joebritt/usb2cmi/README.md

# usb2cmi
USB Keyboard &amp; Mouse interface for the Fairlight CMI

More info can be found here:

https://docs.google.com/document/d/1SBbrsyc7bVfPzIFhJmcOLwGjMr6u-KO0Lp5tNpQLhYE/edit?usp=sharing
