joebritt/usb2cmi/USB2CMI_2018/usb2cmi_s3.pdf

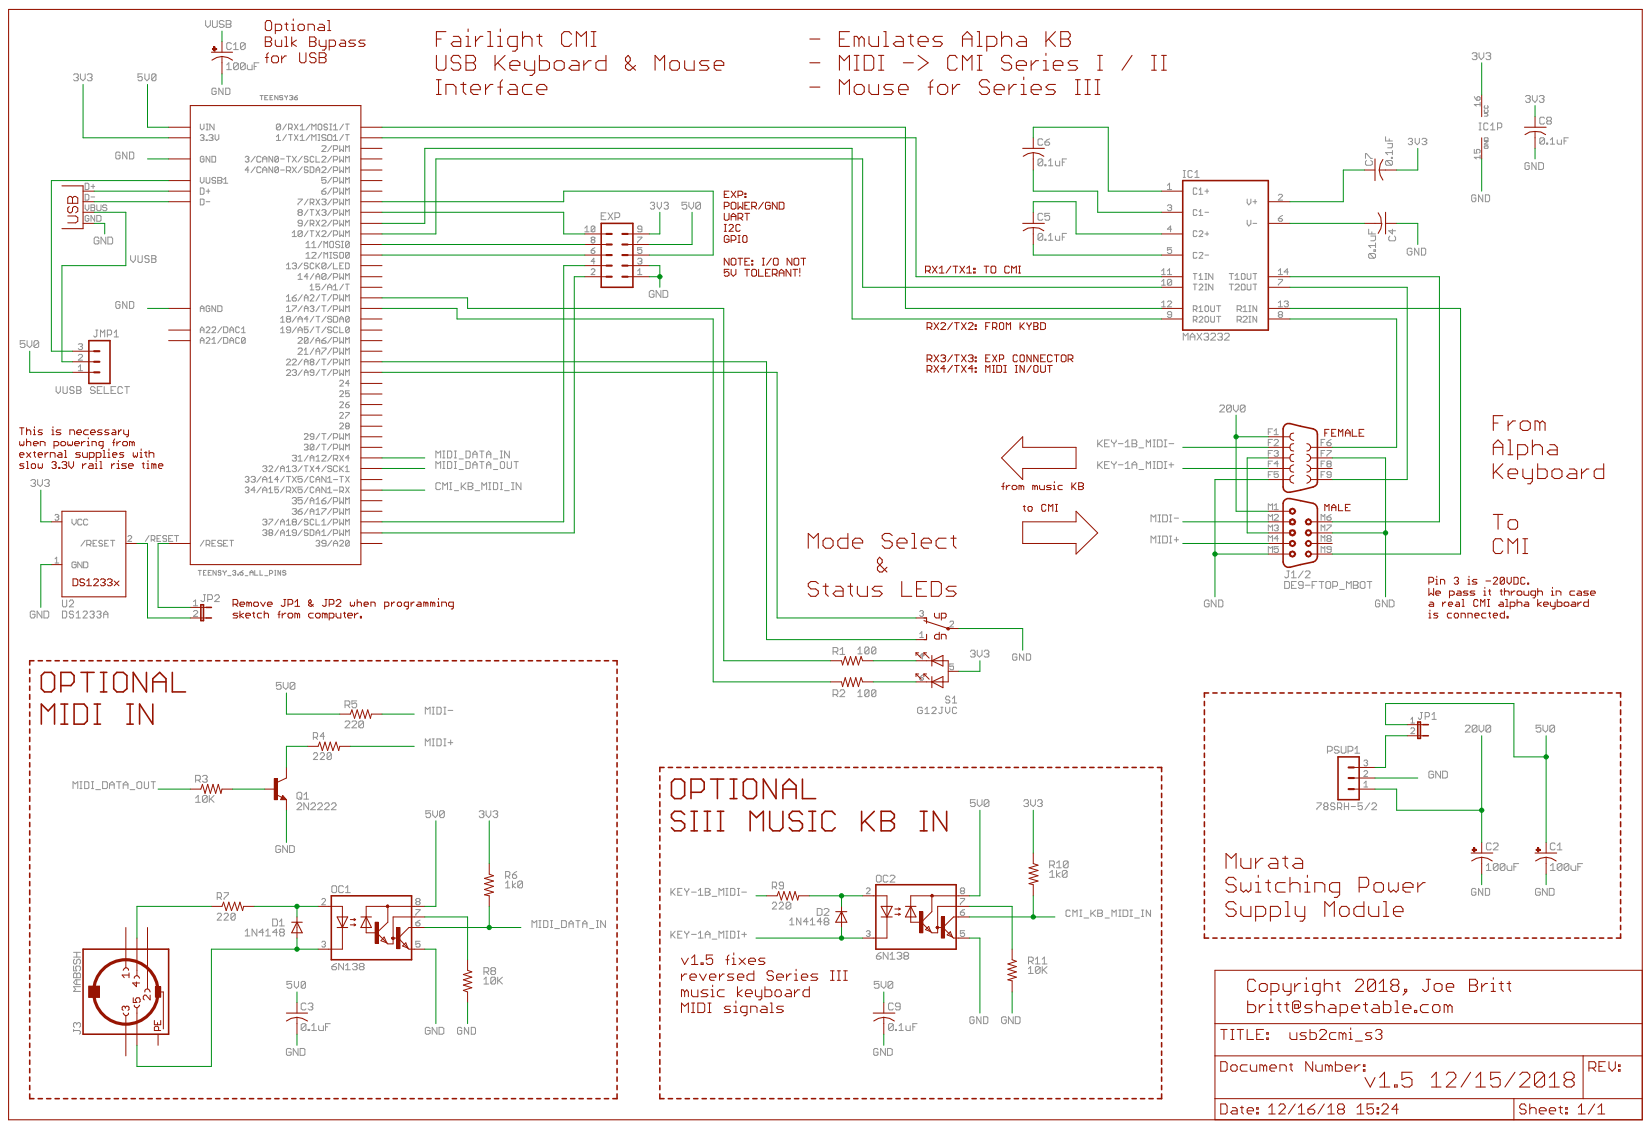
[picture p1: page 1]
