joebritt/usb2cmi/USB2CMI_2018/usb2cmi_s3_disp_sch.pdf

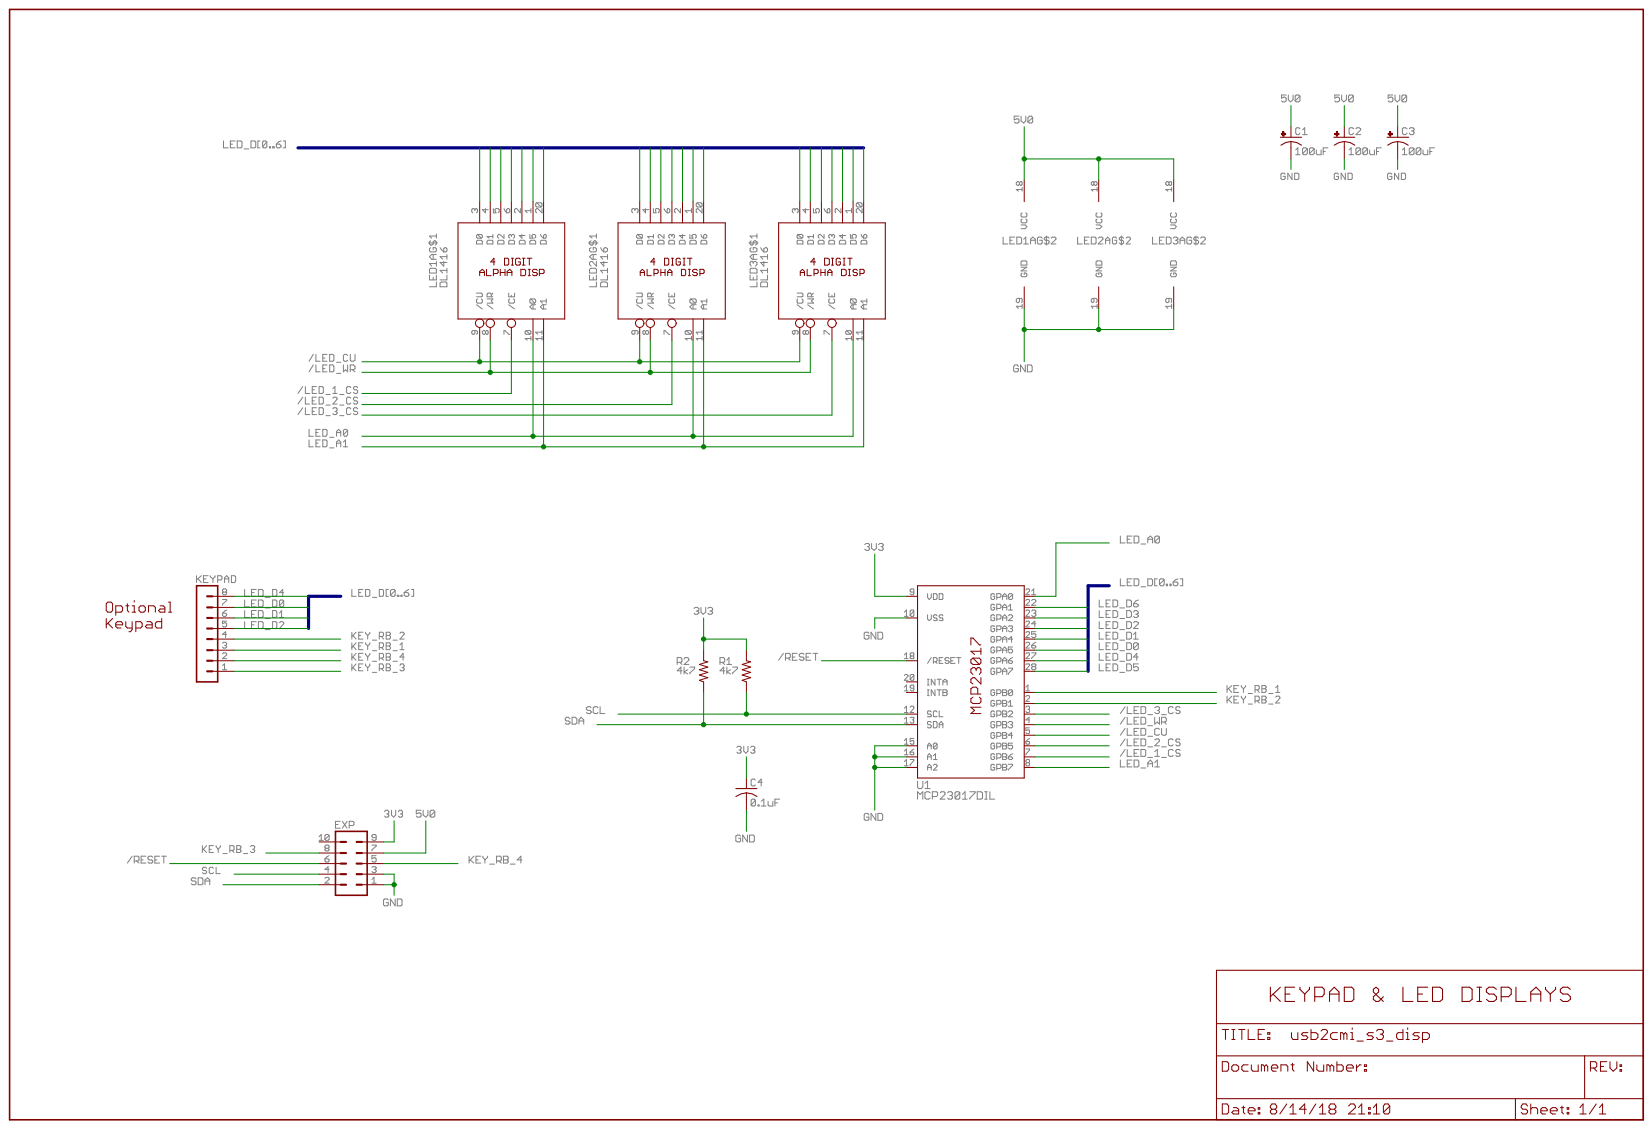
[picture p2: page 1]
