joebritt/usb2cmi/USB2CMI_2018/usb2cmi_s3_sch.pdf

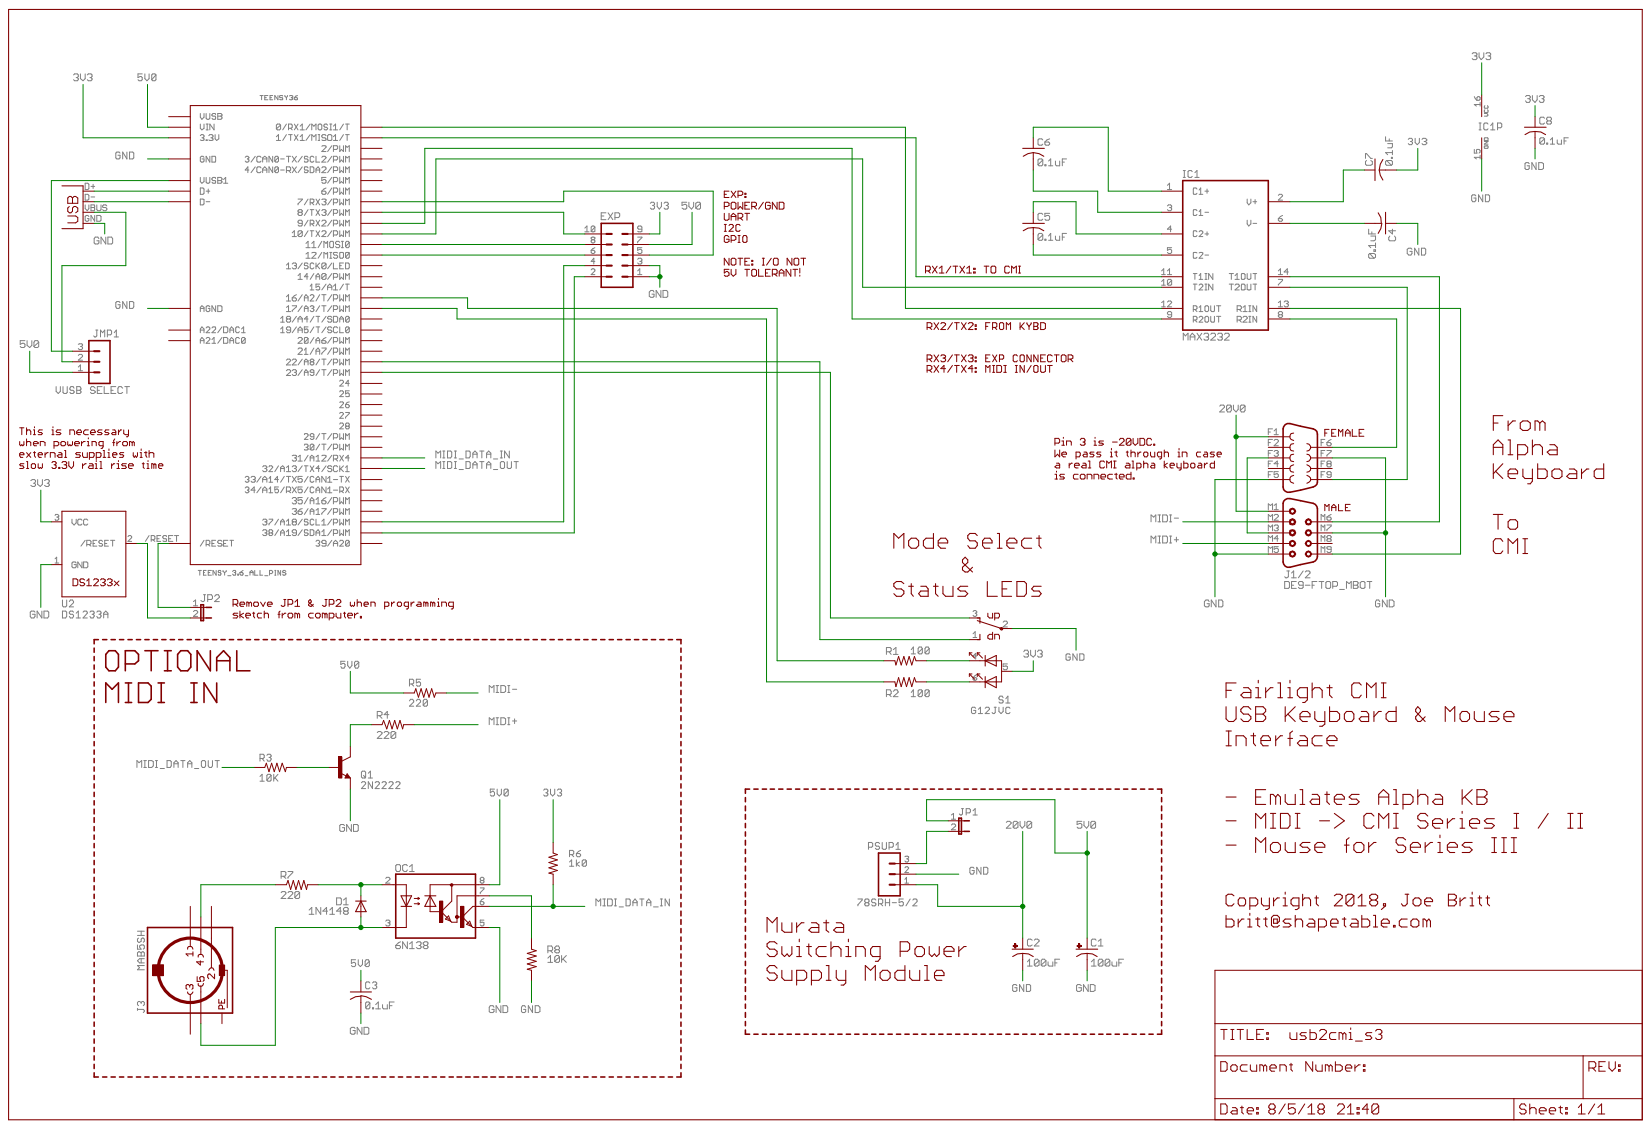
[picture p3: page 1]
