joebritt/usb2cmi/USB2CMI_2018/usb2cmi_mini_disp.brd

## EAGLE design USB2CMI_2018/usb2cmi_mini_disp.brd (2019-04-12)

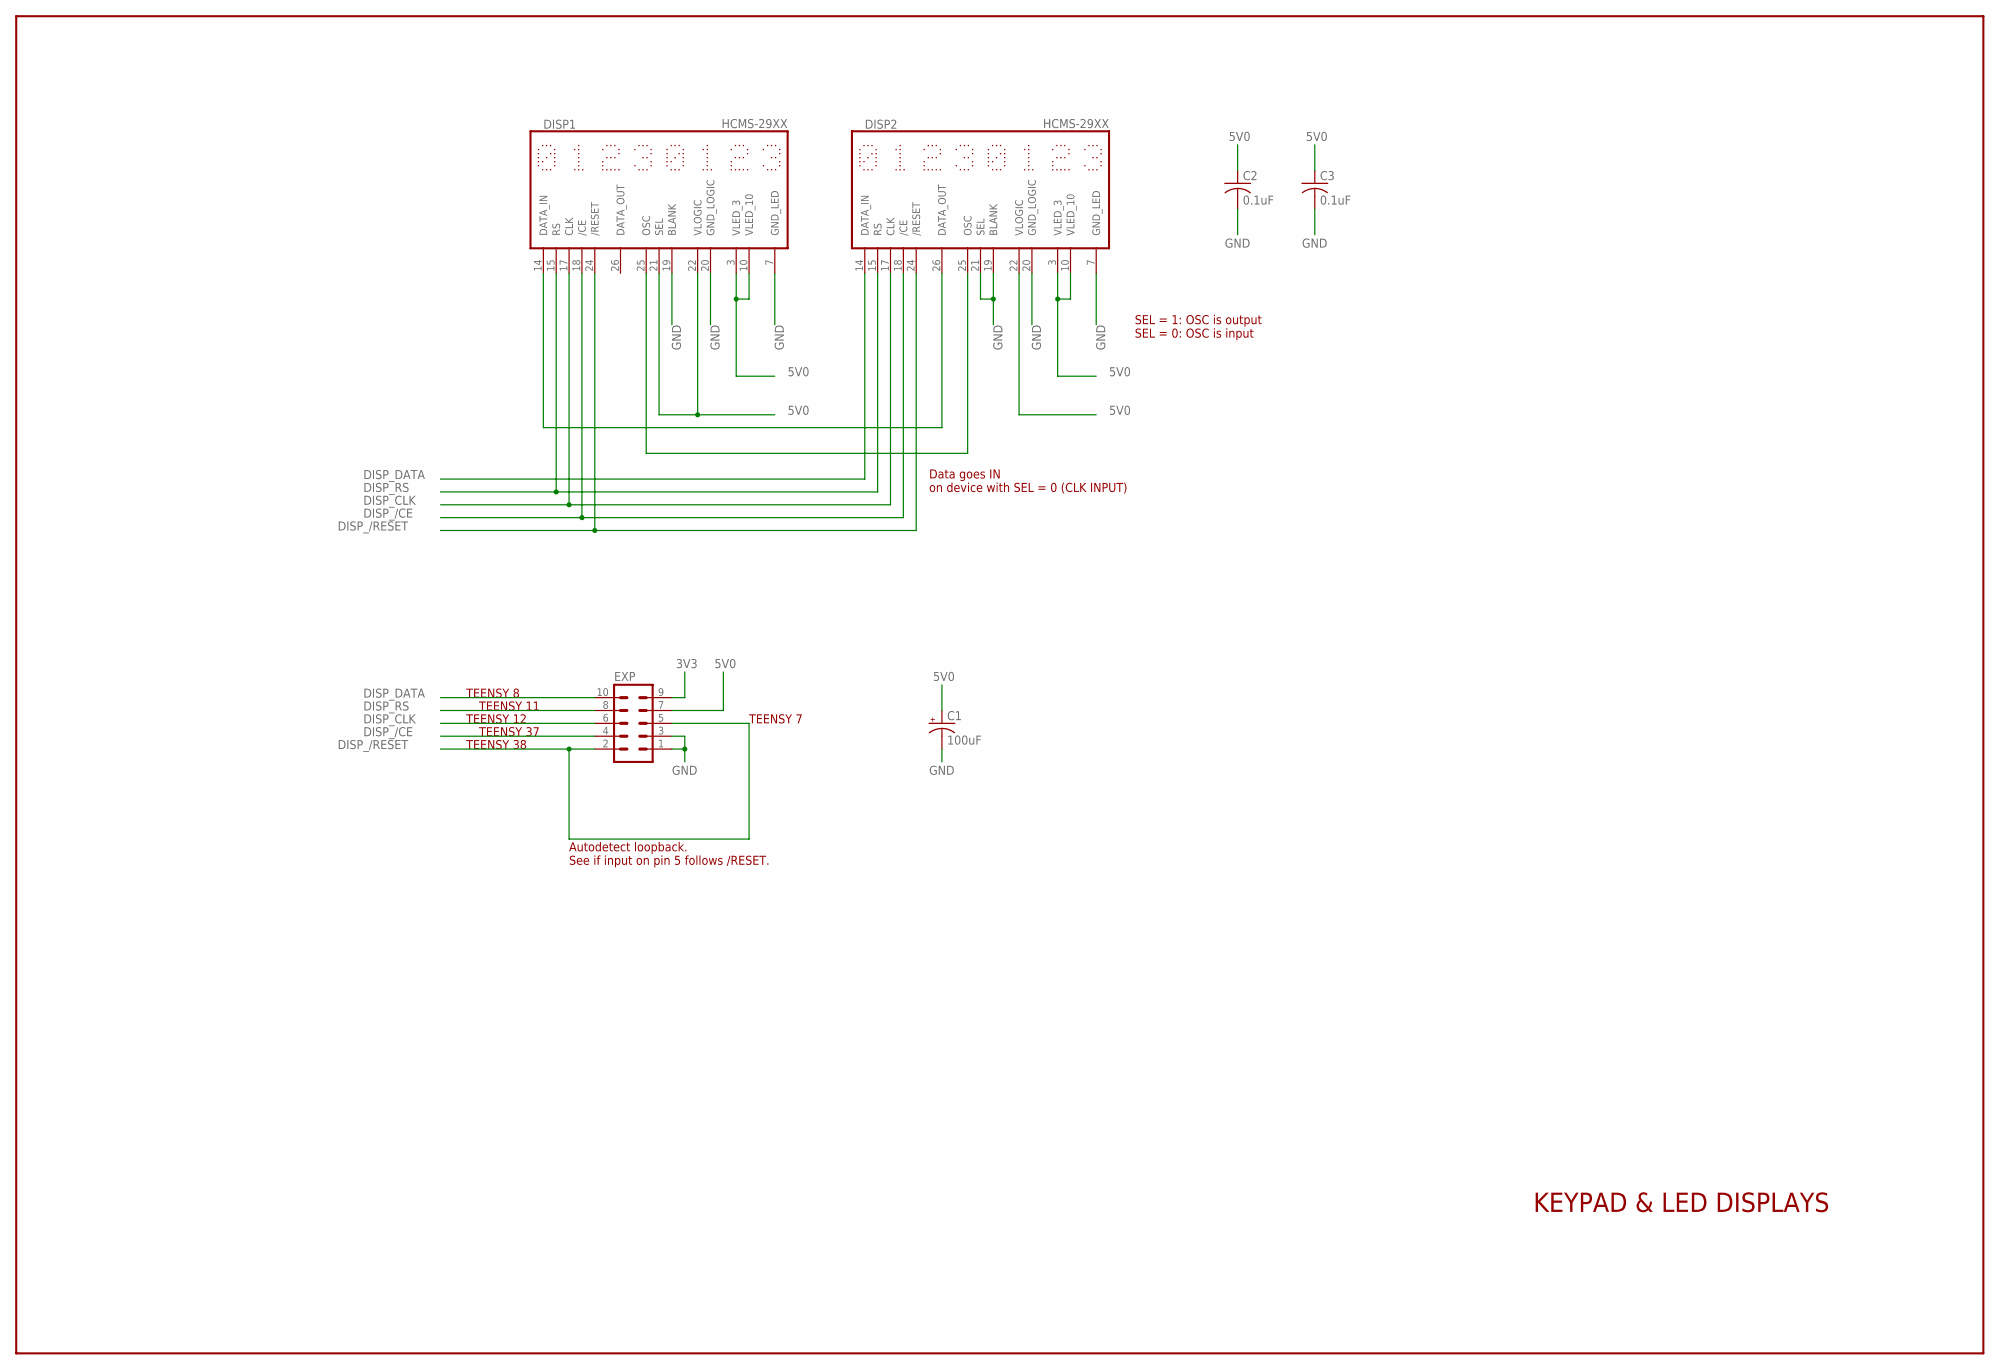
[picture p4: schematic usb2cmi_mini_disp.sch]

Parts:
C1: 100uF; E2,5-7
C2, C3: 0.1uF; C050-025X075
DISP1, DISP2: HCMS-29XX
EXP: MA05-2

Connections:
3V3: EXP.9
5V0: C1.+, C2.1, C3.1, DISP1.3 (VLED_3), DISP1.10 (VLED_10), DISP1.21 (SEL), DISP1.22 (VLOGIC), DISP2.3 (VLED_3), DISP2.10 (VLED_10), DISP2.22 (VLOGIC), EXP.7
DISP_/CE: DISP1.18 (/CE), DISP2.18 (/CE), EXP.4
DISP_/RESET: DISP1.24 (/RESET), DISP2.24 (/RESET), EXP.2, EXP.5
DISP_CLK: DISP1.17 (CLK), DISP2.17 (CLK), EXP.6
DISP_DATA: DISP2.14 (DATA_IN), EXP.10
DISP_RS: DISP1.15 (RS), DISP2.15 (RS), EXP.8
GND: C1.-, C2.2, C3.2, DISP1.7 (GND_LED), DISP1.19 (BLANK), DISP1.20 (GND_LOGIC), DISP2.7 (GND_LED), DISP2.19 (BLANK), DISP2.20 (GND_LOGIC), DISP2.21 (SEL), EXP.1, EXP.3
unnamed: DISP1.14 (DATA_IN), DISP2.26 (DATA_OUT)
unnamed: DISP1.25 (OSC), DISP2.25 (OSC)

Notes on the sheet:
KEYPAD & LED DISPLAYS
SEL = 1: OSC is output SEL = 0: OSC is input
Autodetect loopback. See if input on pin 5 follows /RESET.
Data goes IN on device with SEL = 0 (CLK INPUT)
TEENSY 7
TEENSY 38
TEENSY 37
TEENSY 12
TEENSY 11
TEENSY 8

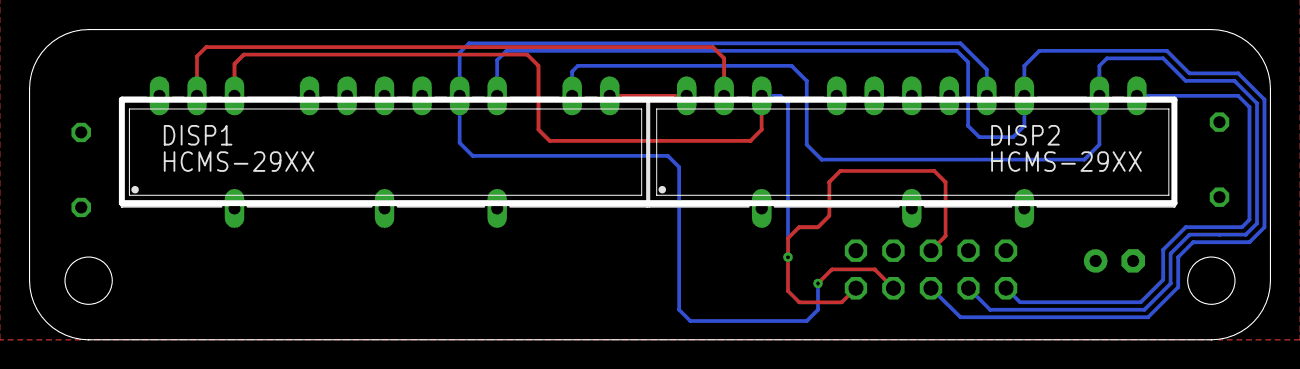
[picture p5: board usb2cmi_mini_disp.brd from above]

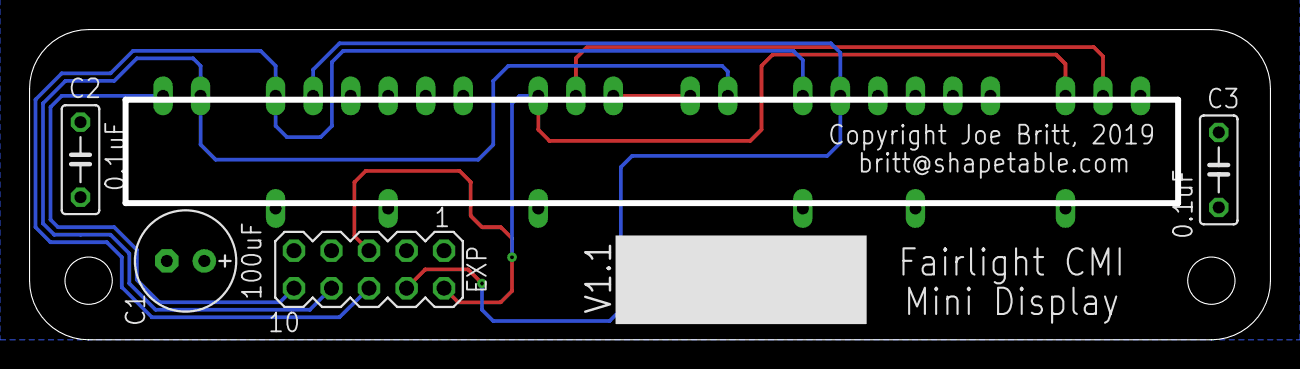
[picture p6: board usb2cmi_mini_disp.brd from below]

Board: 2 copper layers, 84.0 x 21.0 mm, 6 parts (4 on the bottom side), 9 nets.
