joebritt/usb2cmi/USB2CMI_2018/usb2cmi_s3.brd

## EAGLE design USB2CMI_2018/usb2cmi_s3.brd (2018-12-16)

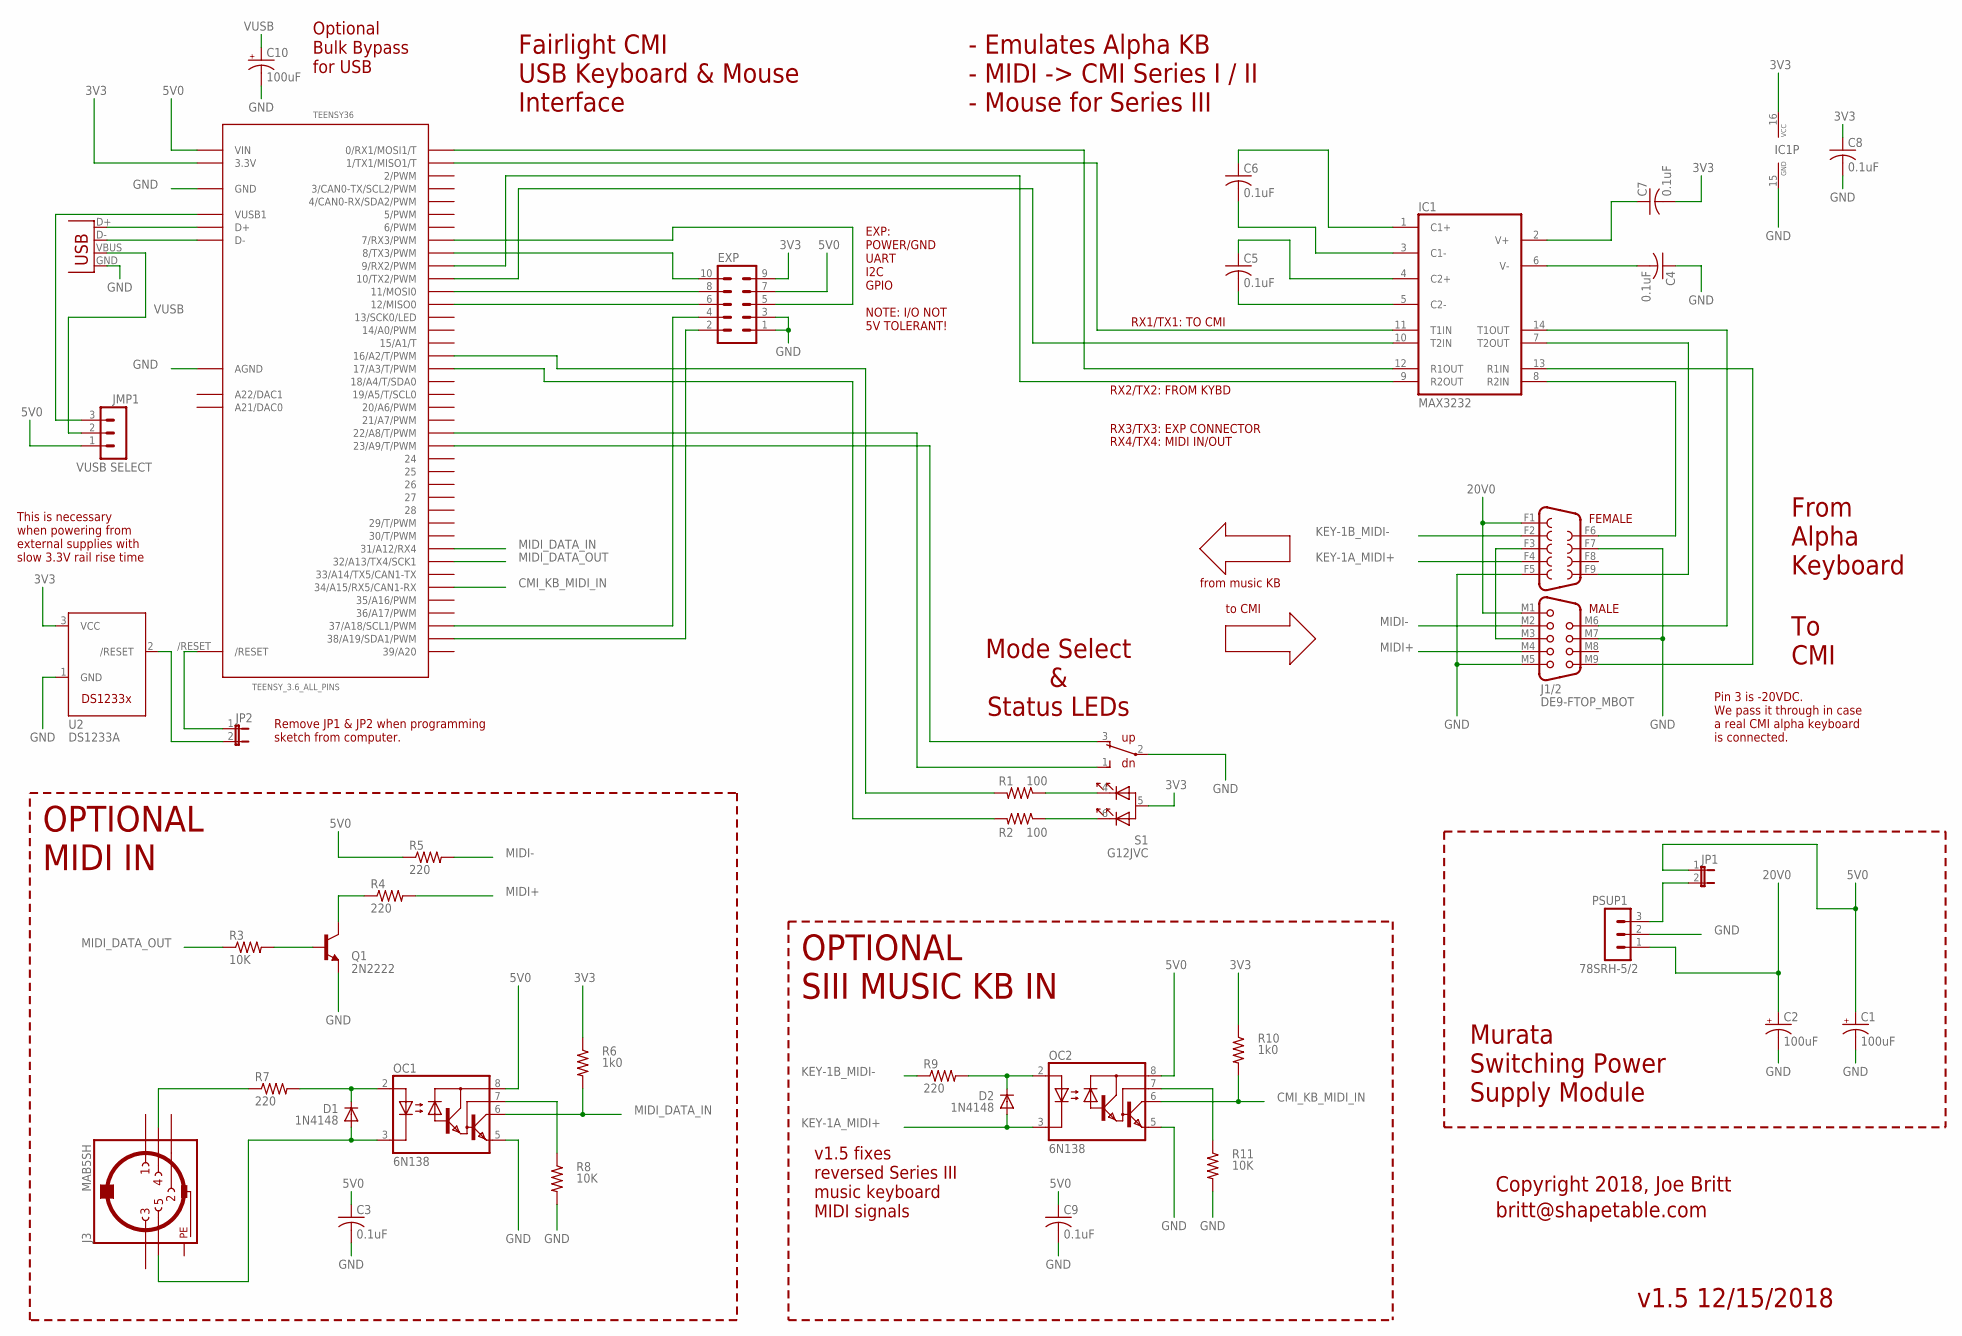
[picture p7: schematic usb2cmi_s3.sch]

Parts:
C1, C10: 100uF; E2,5-7
C2: 100uF; E3,5-10
C3, C4, C5, C6, C7, C8, C9: 0.1uF; C050-025X075
D1, D2: 1N4148; DO35-7
EXP: MA05-2
IC1: MAX3232; DIL16
J1/2: DE9-FTOP_MBOT; DE9_FTOP_MBOT
J3: MAB5SH
J4: USB-A-H
JMP1: VUSB SELECT; MA03-1
JP1, JP2: JP1E; JP1
OC1, OC2: 6N138; DIL08-NARROW
PSUP1: 78SRH-5/2; MA03-1
Q1: 2N2222; TO92-EBC-OVAL
R1, R2: 100; 0207/10
R3, R8, R11: 10K; 0207/10
R4, R5, R7, R9: 220; 0207/10
R6, R10: 1k0; 0207/10
S1: G12JVC
TEENSY36: TEENSY_3.6_ALL_PINS
U2: DS1233A; TO-92-

Connections:
3V3: C7.2, C8.1, EXP.9, IC1.16 (VCC), R6.1, R10.1, S1.5 (A), TEENSY36.3.3V, TEENSY36.3.3V3 (3.3V), U2.3 (VCC)
5V0: C1.+, C3.1, C9.1, EXP.7, JMP1.1, JP1.1, OC1.8 (VCC), OC2.8 (VCC), R5.1, TEENSY36.VIN
20V0: C2.+, J1/2.F1, J1/2.M1, PSUP1.1
CMI_KB_MIDI_IN: OC2.6 (VO), R10.2, TEENSY36.34/A15 (34/A15/RX5/CAN1-RX)
GND: C1.-, C2.-, C3.2, C4.1, C8.2, C9.2, C10.-, EXP.1, EXP.3, IC1.15 (GND), J1/2.F5, J1/2.F7, J1/2.M5, J1/2.M7, J4.GND, OC1.5 (GND), OC2.5 (GND), PSUP1.2, Q1.E, R8.2, R11.2, S1.2 (COM), TEENSY36.AGND, TEENSY36.GND, TEENSY36.GND1 (GND), TEENSY36.GND3 (GND), TEENSY36.GND4 (GND), U2.1 (GND)
KEY-1A_MIDI+: D2.A, J1/2.F4, OC2.3 (C)
KEY-1B_MIDI-: J1/2.F2, R9.1
MIDI+: J1/2.M4, R4.2
MIDI-: J1/2.M2, R5.2
MIDI_DATA_IN: OC1.6 (VO), R6.2, TEENSY36.31/A12 (31/A12/RX4)
MIDI_DATA_OUT: R3.1, TEENSY36.32/A13 (32/A13/TX4/SCK1)
unnamed: JP2.1, TEENSY36./RESET
unnamed: JP2.2, U2.2 (/RESET)
unnamed: EXP.5, TEENSY36.7 (7/RX3/PWM)
unnamed: EXP.10, TEENSY36.8 (8/TX3/PWM)
unnamed: EXP.8, TEENSY36.11 (11/MOSI0)
unnamed: EXP.6, TEENSY36.12 (12/MISO0)
unnamed: IC1.9 (R2OUT), TEENSY36.9 (9/RX2/PWM)
unnamed: R1.1, S1.4 (K_RED)
unnamed: R2.1, S1.6 (K_GRN)
unnamed: R2.2, TEENSY36.17/A3 (17/A3/T/PWM)
unnamed: R1.2, TEENSY36.16/A2 (16/A2/T/PWM)
unnamed: S1.1 (DOWN), TEENSY36.22/A8 (22/A8/T/PWM)
unnamed: S1.3 (UP), TEENSY36.23/A9 (23/A9/T/PWM)
unnamed: J4.D+, TEENSY36.D+
unnamed: J4.D-, TEENSY36.D-
unnamed: JMP1.3, TEENSY36.VUSB1
unnamed: C5.2, IC1.5 (C2-)
unnamed: C5.1, IC1.4 (C2+)
unnamed: C6.2, IC1.3 (C1-)
unnamed: C6.1, IC1.1 (C1+)
unnamed: C4.2, IC1.6 (V-)
unnamed: IC1.11 (T1IN), TEENSY36.1 (1/TX1/MISO1/T)
unnamed: Q1.B, R3.2
unnamed: IC1.14 (T1OUT), J1/2.M6
unnamed: C7.1, IC1.2 (V+)
unnamed: D1.C, OC1.2 (A), R7.2
unnamed: D1.A, J3.5, OC1.3 (C)
unnamed: Q1.C, R4.1
unnamed: J3.4, R7.1
unnamed: IC1.13 (R1IN), J1/2.M9
unnamed: IC1.12 (R1OUT), TEENSY36.0 (0/RX1/MOSI1/T)
unnamed: IC1.10 (T2IN), TEENSY36.10 (10/TX2/PWM)
unnamed: IC1.8 (R2IN), J1/2.F6
unnamed: IC1.7 (T2OUT), J1/2.F9
unnamed: J1/2.F3, J1/2.M3
unnamed: OC1.7 (VB), R8.1
unnamed: JP1.2, PSUP1.3
unnamed: D2.C, OC2.2 (A), R9.2
unnamed: OC2.7 (VB), R11.1
PE: J3.PE, J3.PE@ (PE)
SCL1: EXP.4, TEENSY36.37/A18 (37/A18/SCL1/PWM)
SDA1: EXP.2, TEENSY36.38/A19 (38/A19/SDA1/PWM)
VUSB: C10.+, J4.VBUS, JMP1.2

Notes on the sheet:
OPTIONAL MIDI IN
Murata Switching Power Supply Module
From Alpha Keyboard
To CMI
RX1/TX1: TO CMI
RX2/TX2: FROM KYBD
RX3/TX3: EXP CONNECTOR
RX4/TX4: MIDI IN/OUT
EXP: POWER/GND UART I2C GPIO NOTE: I/O NOT 5V TOLERANT!
Mode Select & Status LEDs
Pin 3 is -20VDC. We pass it through in case a real CMI alpha keyboard is connected.
Copyright 2018, Joe Britt
britt@shapetable.com
Fairlight CMI USB Keyboard & Mouse Interface
- Emulates Alpha KB - MIDI -> CMI Series I / II - Mouse for Series III
This is necessary when powering from external supplies with slow 3.3V rail rise time
Remove JP1 & JP2 when programming sketch from computer.
from music KB
to CMI
OPTIONAL SIII MUSIC KB IN
Optional Bulk Bypass for USB
v1.5 fixes reversed Series III music keyboard MIDI signals
v1.5 12/15/2018

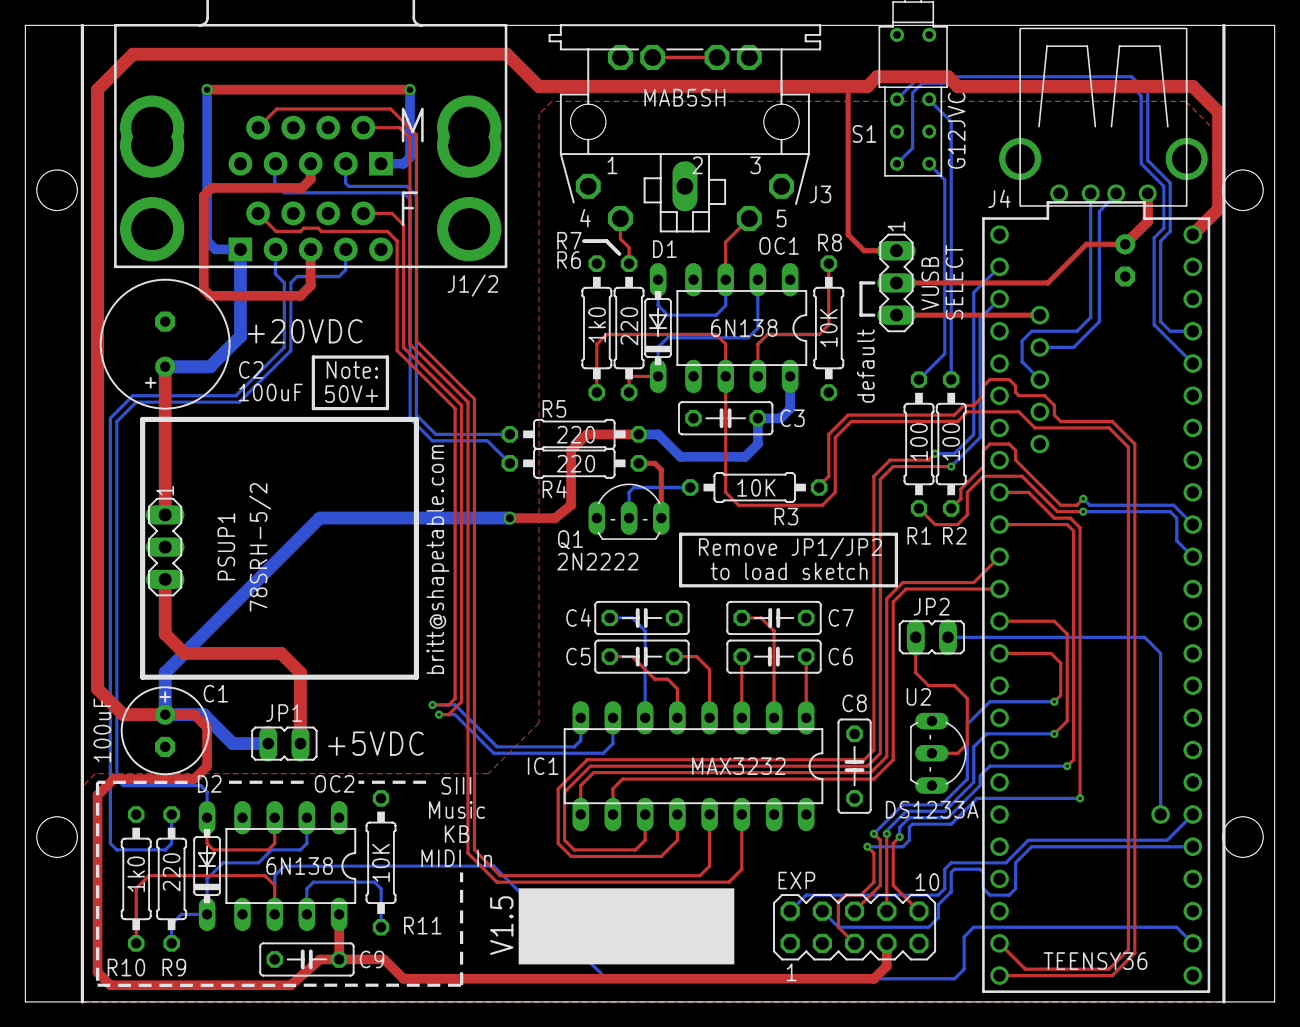
[picture p8: board usb2cmi_s3.brd from above]

Board: 2 copper layers, 98.5 x 77.0 mm, 38 parts (1 on the bottom side), 54 nets.
