joebritt/usb2cmi/USB2CMI_2018/usb2cmi_s3_disp.brd

## EAGLE design USB2CMI_2018/usb2cmi_s3_disp.brd (2018-09-01)

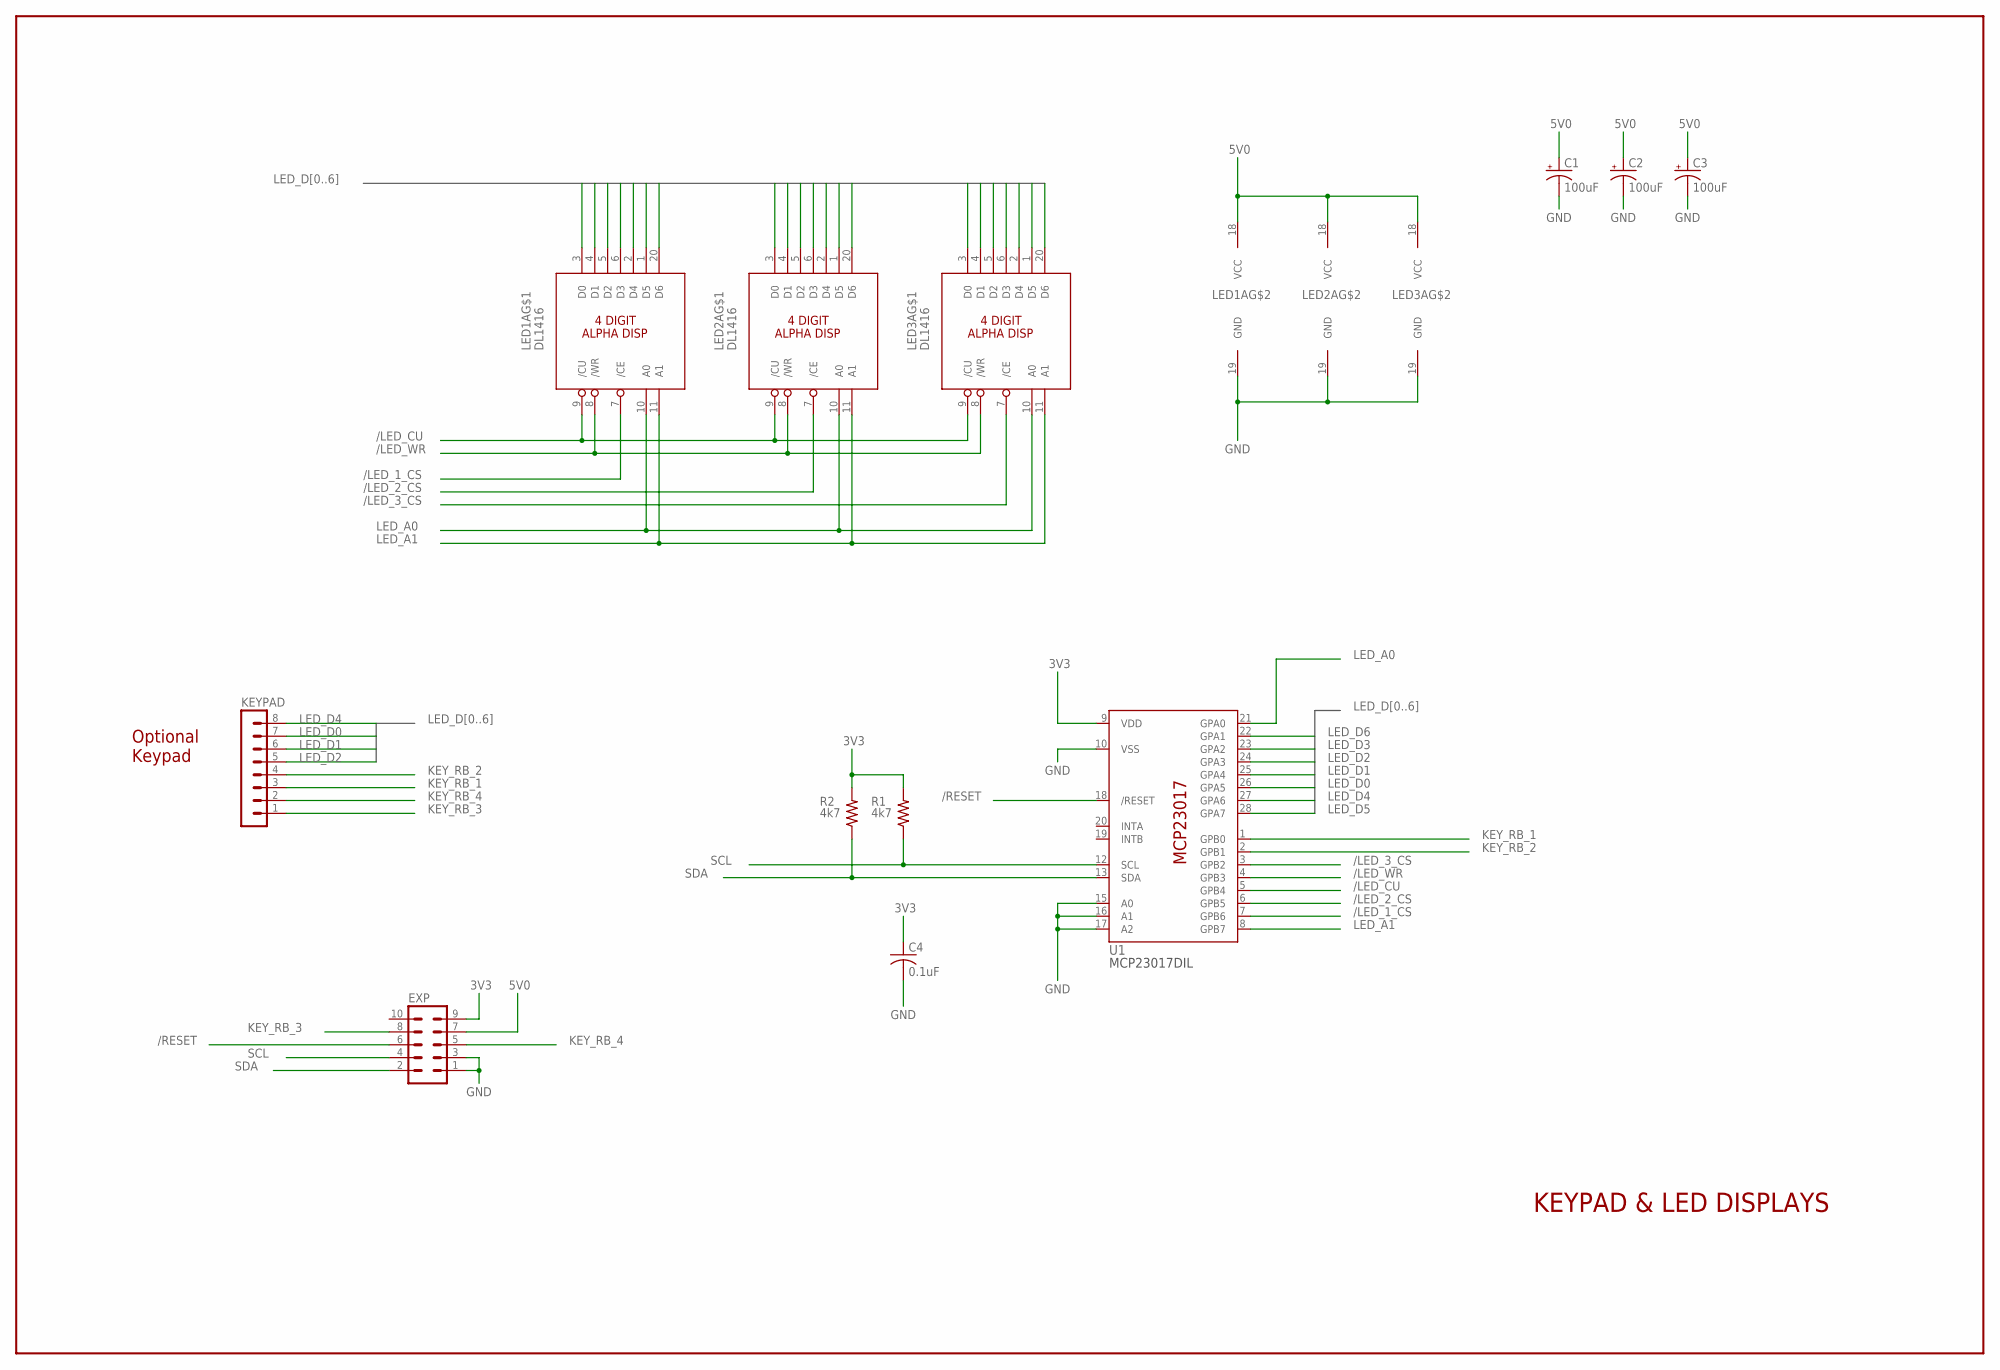
[picture p9: schematic usb2cmi_s3_disp.sch]

Parts:
C1, C2, C3: 100uF; E2,5-7
C4: 0.1uF; C050-025X075
EXP: MA05-2
KEYPAD: MA08-1
LED1A, LED2A, LED3A: DL1416; DIL20
R1, R2: 4k7; 0207/10
U1: MCP23017DIL; DIL28-3

Connections:
3V3: C4.1, EXP.9, R1.2, R2.2, U1.9 (VDD)
5V0: C1.+, C2.+, C3.+, EXP.7, LED1A.18 (VCC), LED2A.18 (VCC), LED3A.18 (VCC)
/LED_1_CS: LED1A.7 (/CE), U1.7 (GPB6)
/LED_2_CS: LED2A.7 (/CE), U1.6 (GPB5)
/LED_3_CS: LED3A.7 (/CE), U1.3 (GPB2)
/LED_CU: LED1A.9 (/CU), LED2A.9 (/CU), LED3A.9 (/CU), U1.5 (GPB4)
/LED_WR: LED1A.8 (/WR), LED2A.8 (/WR), LED3A.8 (/WR), U1.4 (GPB3)
/RESET: EXP.6, U1.18 (/RESET)
GND: C1.-, C2.-, C3.-, C4.2, EXP.1, EXP.3, LED1A.19 (GND), LED2A.19 (GND), LED3A.19 (GND), U1.10 (VSS), U1.15 (A0), U1.16 (A1), U1.17 (A2)
KEY_RB_1: KEYPAD.3, U1.1 (GPB0)
KEY_RB_2: KEYPAD.4, U1.2 (GPB1)
KEY_RB_3: EXP.8, KEYPAD.1
KEY_RB_4: EXP.5, KEYPAD.2
LED_A0: LED1A.10 (A0), LED2A.10 (A0), LED3A.10 (A0), U1.21 (GPA0)
LED_A1: LED1A.11 (A1), LED2A.11 (A1), LED3A.11 (A1), U1.8 (GPB7)
LED_D0: KEYPAD.7, LED1A.3 (D0), LED2A.3 (D0), LED3A.3 (D0), U1.26 (GPA5)
LED_D1: KEYPAD.6, LED1A.4 (D1), LED2A.4 (D1), LED3A.4 (D1), U1.25 (GPA4)
LED_D2: KEYPAD.5, LED1A.5 (D2), LED2A.5 (D2), LED3A.5 (D2), U1.24 (GPA3)
LED_D3: LED1A.6 (D3), LED2A.6 (D3), LED3A.6 (D3), U1.23 (GPA2)
LED_D4: KEYPAD.8, LED1A.2 (D4), LED2A.2 (D4), LED3A.2 (D4), U1.27 (GPA6)
LED_D5: LED1A.1 (D5), LED2A.1 (D5), LED3A.1 (D5), U1.28 (GPA7)
LED_D6: LED1A.20 (D6), LED2A.20 (D6), LED3A.20 (D6), U1.22 (GPA1)
SCL: EXP.4, R1.1, U1.12 (SCL)
SDA: EXP.2, R2.1, U1.13 (SDA)

Notes on the sheet:
KEYPAD & LED DISPLAYS
Optional Keypad

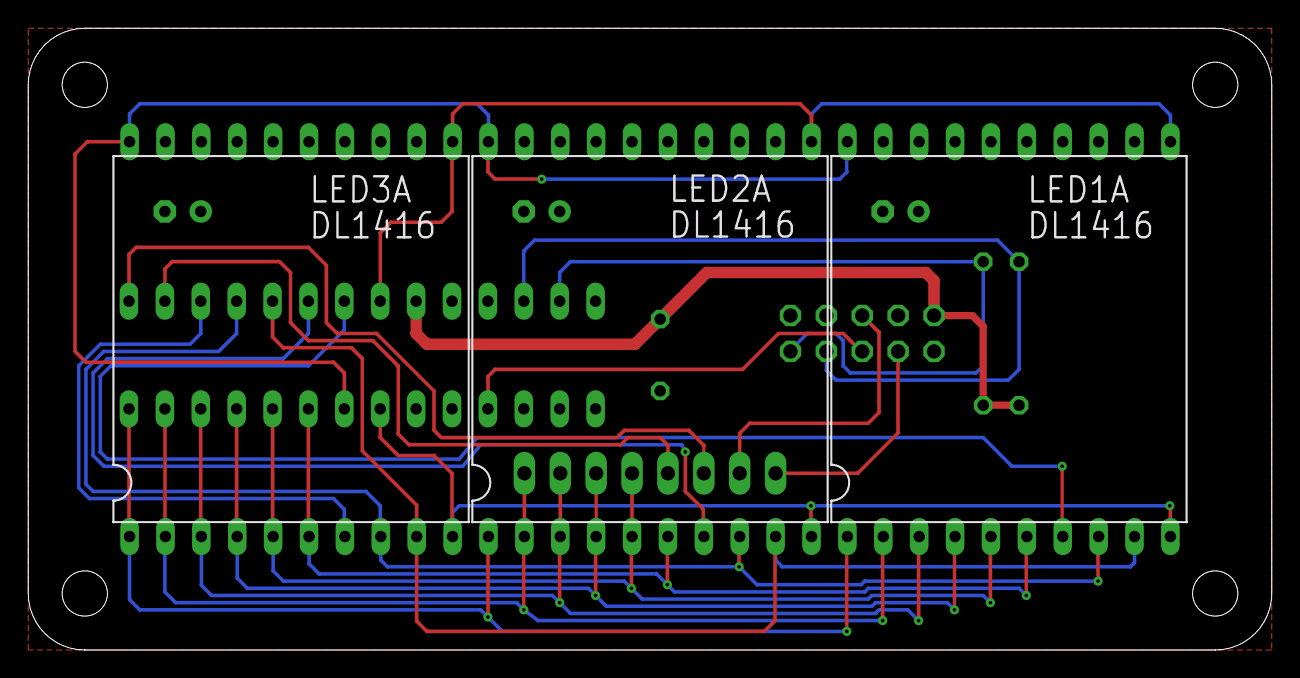
[picture p10: board usb2cmi_s3_disp.brd from above]

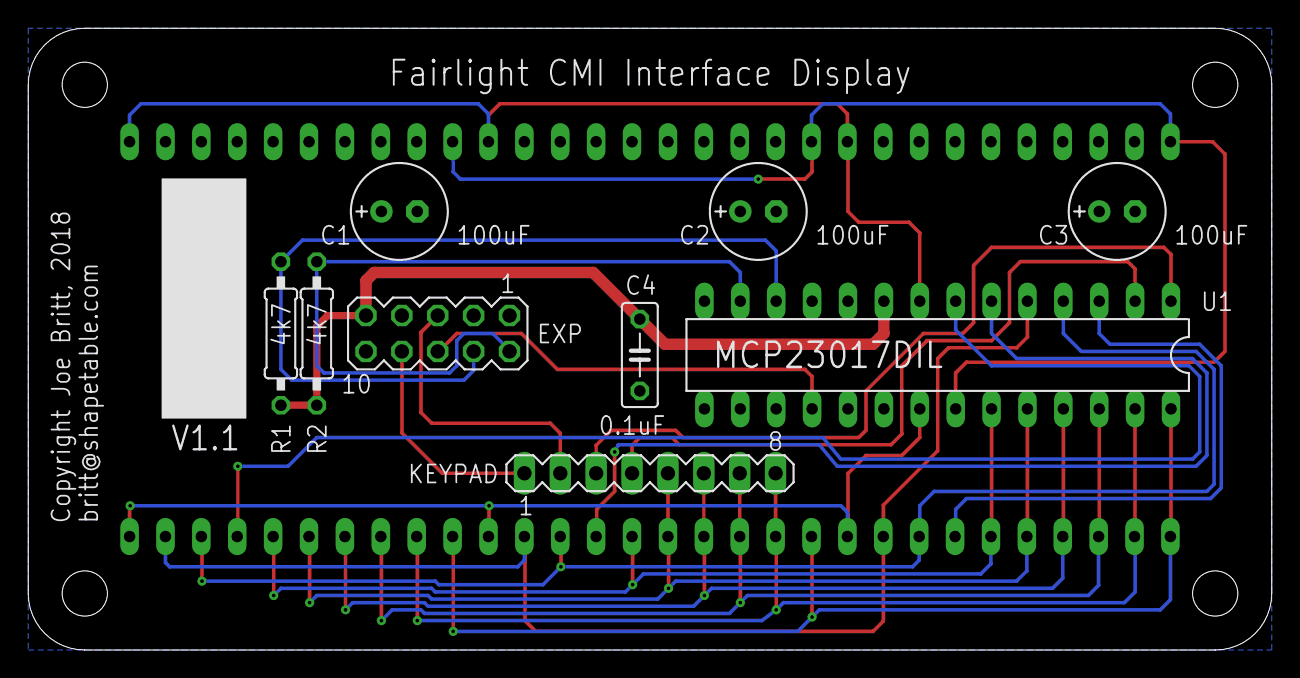
[picture p11: board usb2cmi_s3_disp.brd from below]

Board: 2 copper layers, 88.0 x 44.0 mm, 12 parts (9 on the bottom side), 24 nets.
