joebritt/usb2cmi/(commit log)

2018-08-06 Updates for MIDI and LED display
2018-09-01 Add files via upload
    Eagle schematic & board design files for main board and display board.
    PDF versions of schematics.
    Front Panel Designer files for top & rear aluminum panels.
    PDF of front (display) panel, for laser cutting red plexiglass.
    [usb2cmi_s3.brd, usb2cmi_s3.sch, usb2cmi_s3_disp.brd, usb2cmi_s3_disp.sch]
2018-09-01 Add files via upload
    USB2CMI interface Arduino Sketch
2018-09-01 Add files via upload
    Added delay to legacy music KB LED display write, was seeing digit 2 get the wrong val.
    Added support for MIDI control of Series I/II. Notes and Pitchbend (as Control 1 Slider) implemented.
    [usb2cmi.ino]
2018-09-04 Delete usb2cmi.ino
    accidentally checked into wrong place.
    [usb2cmi.ino]
2018-09-04 Add files via upload
    Autodetect i2c port expander, which is used for the LED displays & keypad.
    If we don't find it at boot assume we don't have it installed, don't try to do any more i2c transactions.
2018-09-08 Add files via upload
    - MIDI Pitchbend -> CMI Control Slider 1
    - MIDI CC 75 - 79 -> CMI Control Sliders 2 - 6
    - MIDI CC 80 - 83 -> CMI Control Switches 1 - 4
    - MIDI CC 16 -> CMI Control Switch 5
    - Removed 1ms delay() when writing to legacy keyboard LED displays
2018-12-10 Add files via upload
    Updated schematic and board v1.4.
    Front Panel Designer file for basic version.
    The main change is addition of a second MIDI optoisolator. This lets the interface also receive MIDI data from a Series III music keyboard (if attached), so we can merge that music keyboard data with MIDI in.
    (This was already supported for Series I/II, which don't use MIDI for their music keyboards.)
    [usb2cmi_s3.brd]
2018-12-10 Add files via upload
    The schematic file seemed to have gotten missed.
2018-12-10 Delete usb2cmi_s3.sch
    going to replace
    [usb2cmi_s3.sch]
2018-12-10 Add files via upload
    Design schematic, v1.4
    [usb2cmi_s3.sch]
2018-12-16 Add files via upload
    v1.5 of USB2CMI PCB.
    Fixes reversed MIDI +/- signals from legacy SIII keyboard.
    Adds optional 100uF bulk bypass cap across USB host power/ground.
    [usb2cmi_s3.brd, usb2cmi_s3.sch]
2018-12-16 Add files via upload
    Verified SIII legacy music keyboard input works.
    Still need to do proper MIDI merge between SIII legacy MIDI keyboard and interface MIDI in.
    Blink version number (count red flashes) on toggle switch LED at boot.
2019-04-12 Mini display board.
    Eagle schematic & PCB design for the small HCMS display version.
    [usb2cmi_mini_disp.brd, usb2cmi_mini_disp.sch]
2019-06-17 v1.3, Add support for HDSP21xx LED displays
    Box now supports HDSP21xx LED displays as well as classic DL1416 displays.
2019-06-17 v13, Add support for HDSP21xx LED displays
2019-12-01 Fix bugs with Shift/Control modifier keys on SIII
    Shift and Control on the USB keyboard now have the proper behavior on SIII.
    Removed some debug code that had been left in.
    Fixed UART definitions, wrong mapping was accidentally checked in last time.
    Increased version to 1.4.
    More details:
    On a Series III system, holding down Shift or Control should change the icons displayed at the bottom of the CMI screen. These icons map onto the F1-F15 function keys, and so the function of a each key changes if Shift or Control is also pressed.
    This wasn't working before.
    Special thanks for Graham Johnson for reporting this bug!
    [usb2cmi.ino]
2020-03-09 Add files via upload
    Fix problem that sometimes prevented mouse from being detected.
    [usb2cmi.ino]
2021-07-18 v1.6, fix shift key bug, use F13/F14/F15 on Apple keyboards
    v1.6
    - Fixed Shift/Control behavior for arrow keys on Series III. Thanks to Cris Blyth and Andrei Kudryavtsev for finding that bug and letting me know about it!
    - Apple USB keyboards have F13, F14, and F15 keys. Map those to CMI F13, F14, and F15.
    [usb2cmi.ino]
