joebritt/usb2cmi/(notices)

Notices in the files:
USB2CMI_2018/usb2cmi_mini_disp.brd:
Copyright Joe Britt, 2019
USB2CMI_2018/usb2cmi_s3_disp.brd:
Copyright Joe Britt, 2018
parts and their libraries:
SparkFun-Connectors: Licensing: Creative Commons ShareAlike 4.0 International - https://creativecommons.org/licenses/by-sa/4.0
